Tinkerforge/dc-brick/software/examples/labview/Example Configuration.vi.png

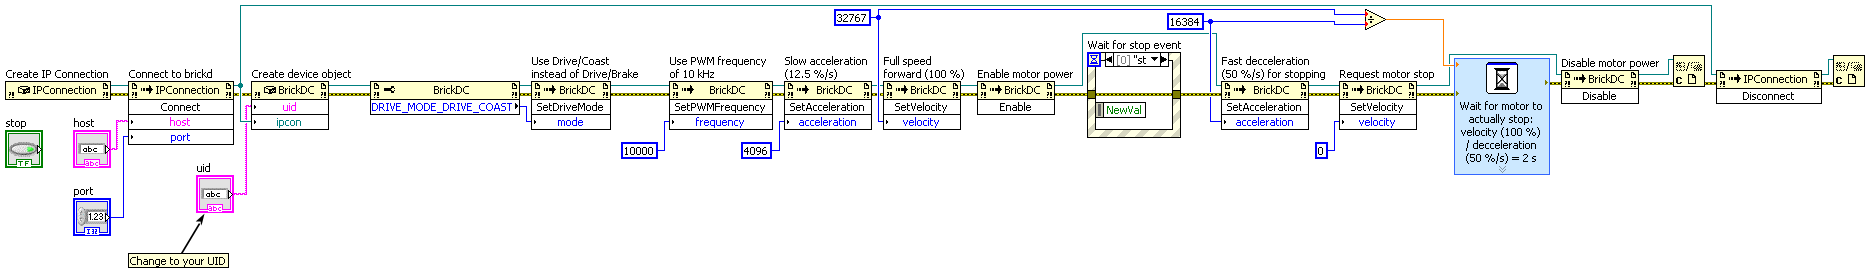
software/examples/labview/Example Configuration.vi.png
