Tinkerforge/dc-brick/hardware/errata.txt

put more space between components and mounting holes
update mounting holes
connectors placement as step down power supply
