Tinkerforge/dc-brick/hardware/dc-schematic.pdf

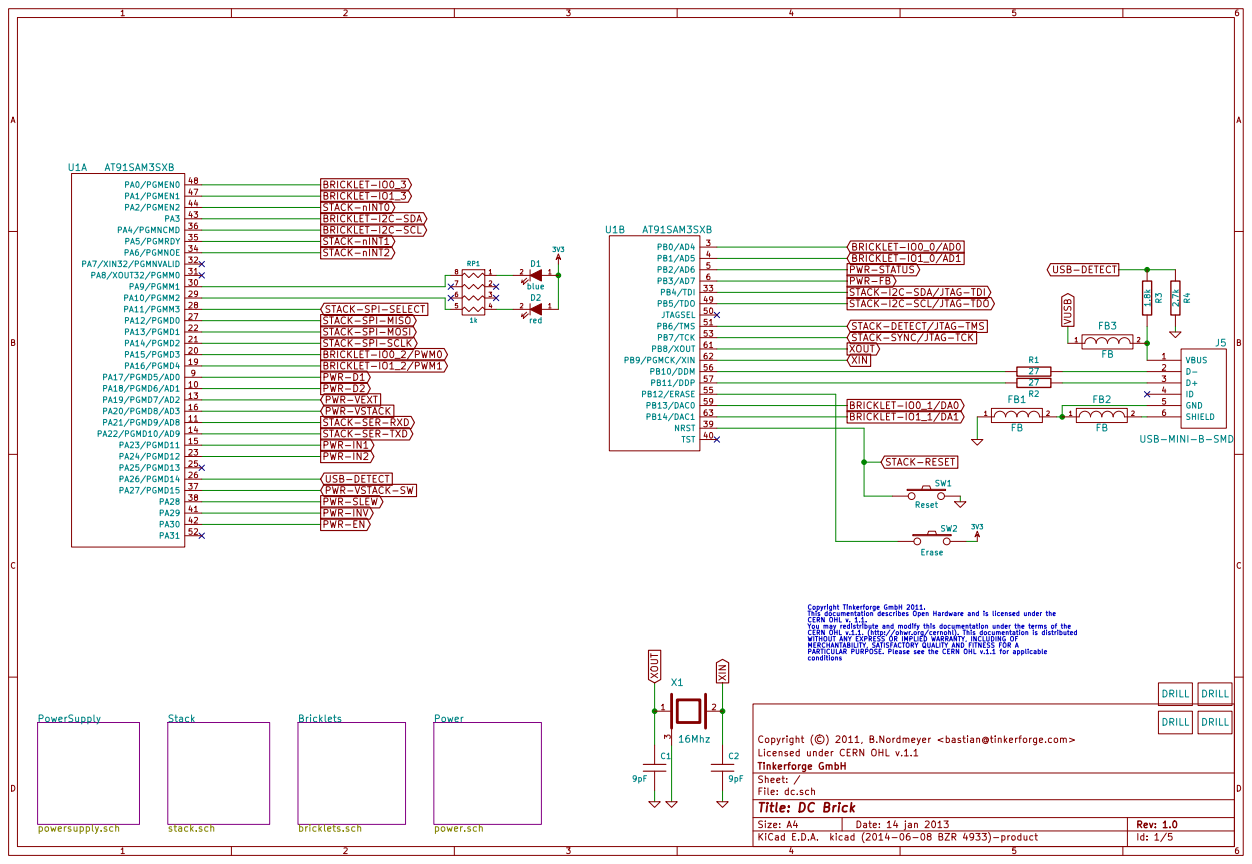
[picture p3: page 1]

BRICKLET-IO0_2/PWM0 Bricklets bricklets.sch
BRICKLET-IO1_2/PWM1
PWR-D2 PWR-D1 PWR-IN2 PWR-IN1 PWR-EN

BRICKLET-IO0_0/AD0
BRICKLET-IO1_0/AD1
PWR-STATUS
PWR-FB
STACK-I2C-SDA/JTAG-TDI
STACK-I2C-SCL/JTAG-TDO

STACK-DETECT/JTAG-TMS
STACK-SYNC/JTAG-TCK
XOUT
XIN

Copyright Tinkerforge GmbH 2011. This documentation describes Open Hardware and is licensed under the CERN OHL v. 1.1. You may redistribute and modify this documentation under the terms of the CERN OHL v.1.1. (http://ohwr.org/cernohl). This documentation is distributed WITHOUT ANY EXPRESS OR IMPLIED WARRANTY, INCLUDING OF MERCHANTABILITY, SATISFACTORY QUALITY AND FITNESS FOR A

PARTICULAR PURPOSE. Please see the CERN OHL v.1.1 for applicable
conditions

Licensed under CERN OHL v.1.1 Copyright (©) 2011, B.Nordmeyer <bastian@tinkerforge.com>

File: dc.sch Sheet: / Tinkerforge GmbH

Id: 1/5 Title: DC Brick

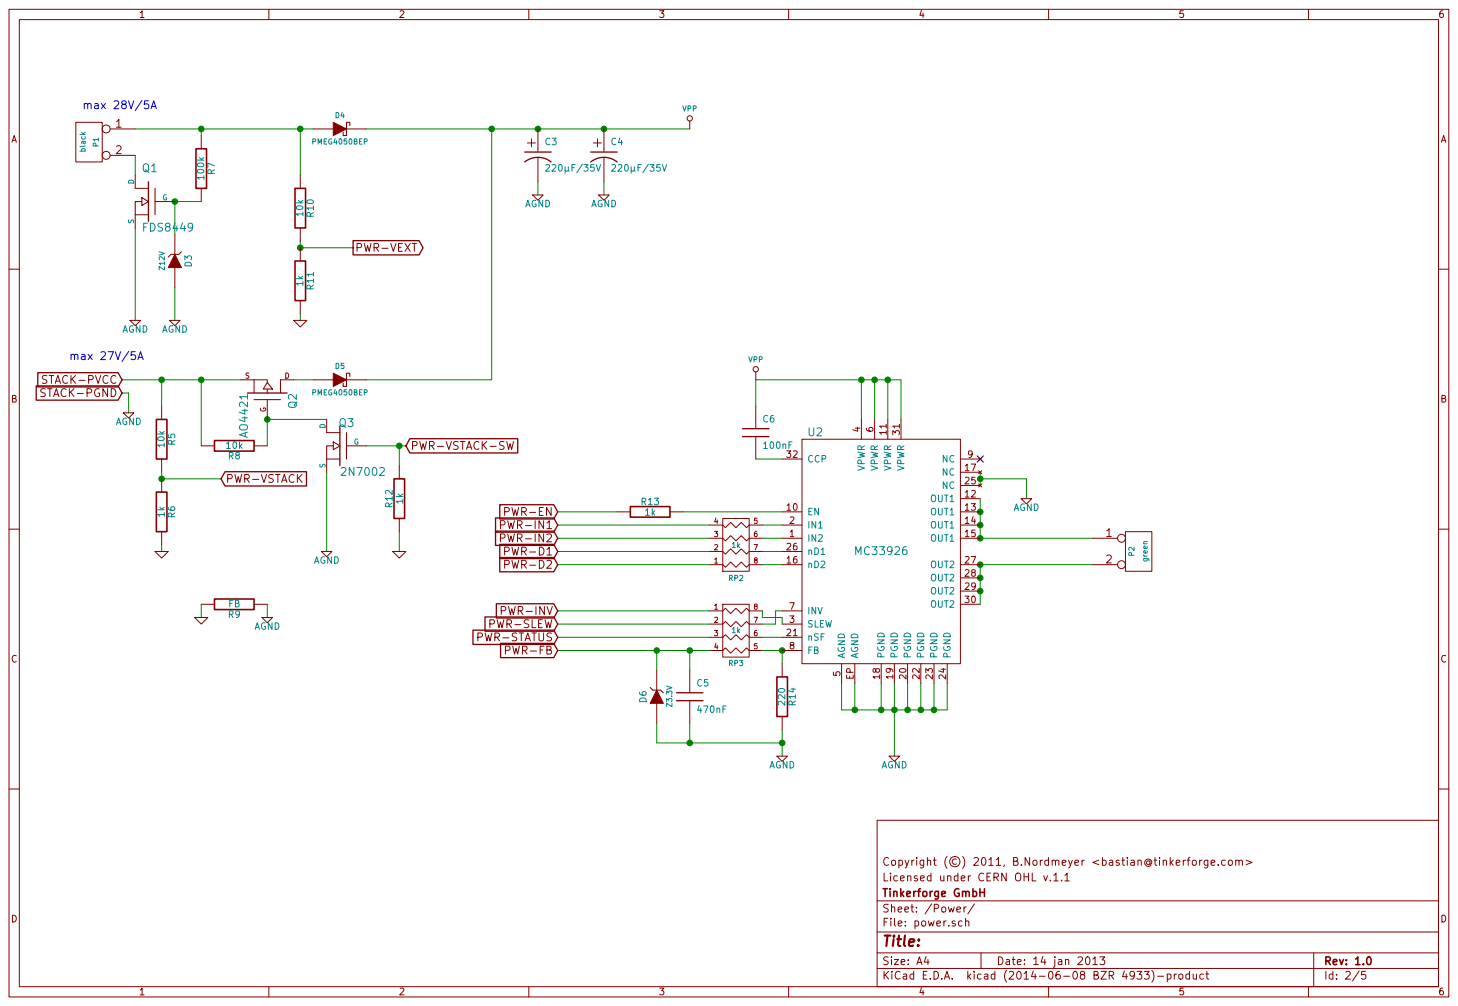
[picture p4: page 2]

Licensed under CERN OHL v.1.1 Copyright (©) 2011, B.Nordmeyer <bastian@tinkerforge.com> PWR-D2

File: power.sch Sheet: /Power/ Tinkerforge GmbH

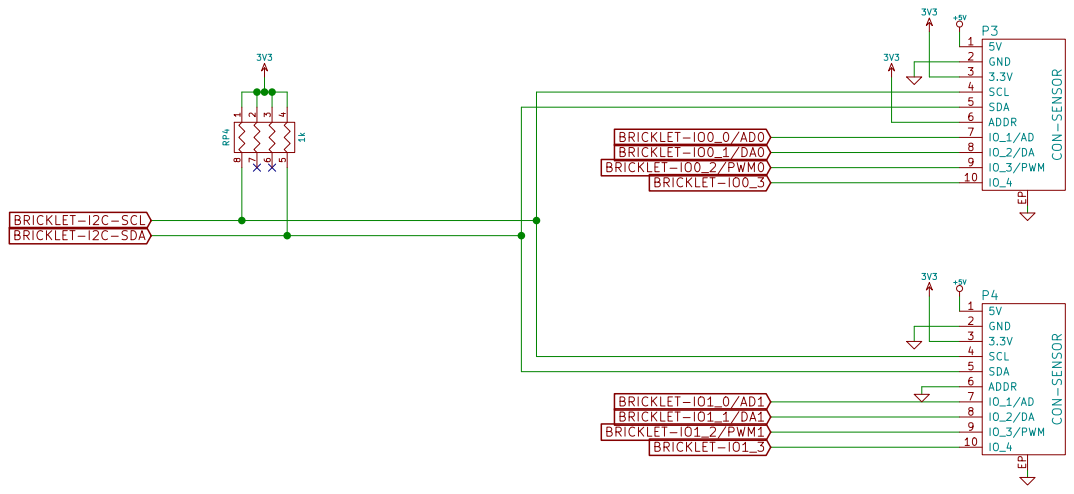
[picture p5: page 3]

Id: 3/5 Title: File: bricklets.sch Sheet: /Bricklets/ Tinkerforge GmbH

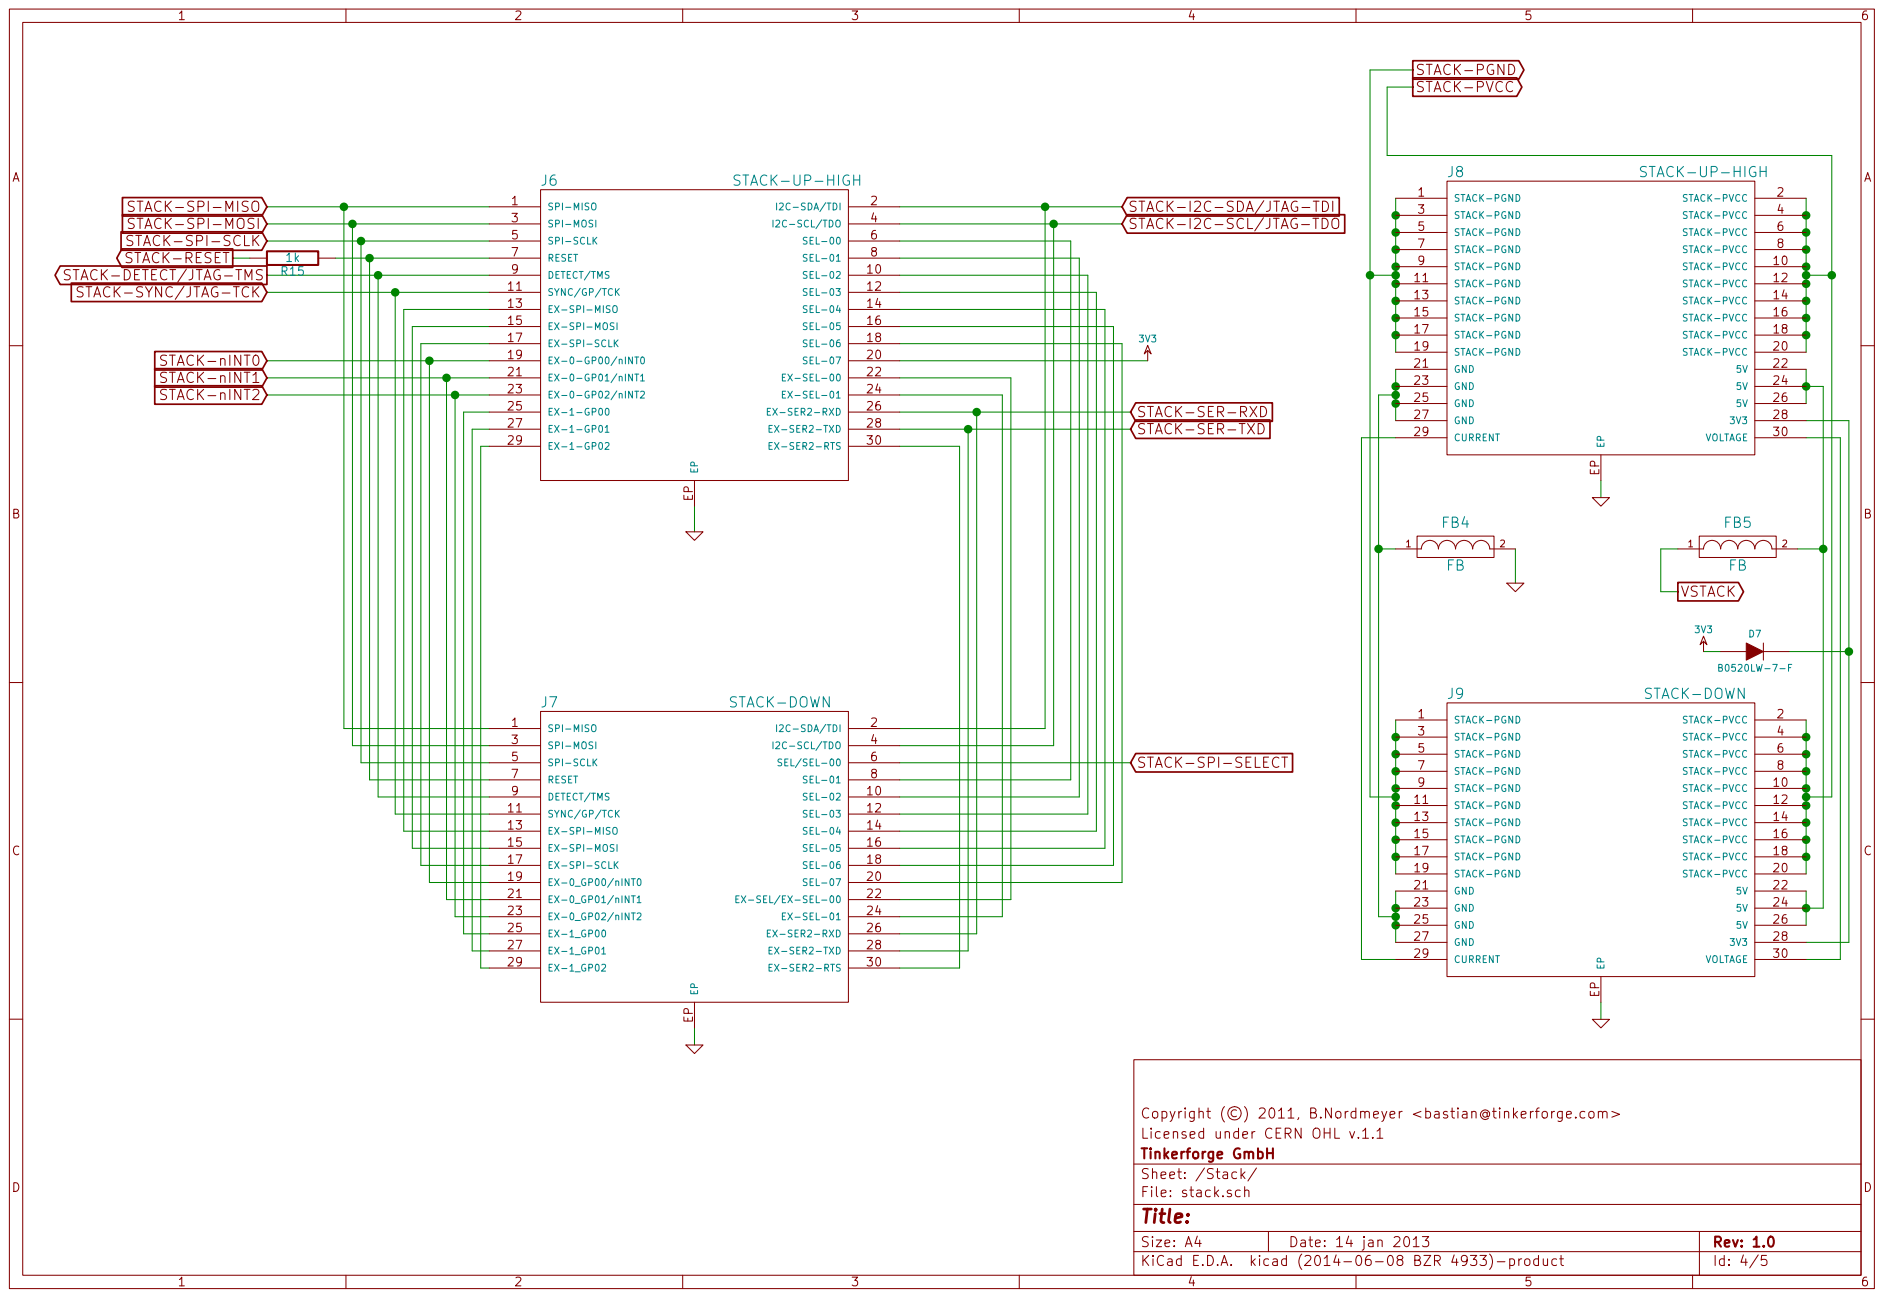
[picture p6: page 4]

STACK-I2C-SDA/JTAG-TDI
STACK-I2C-SCL/JTAG-TDO

STACK-DETECT/JTAG-TMS
STACK-SYNC/JTAG-TCK

Licensed under CERN OHL v.1.1 Copyright (©) 2011, B.Nordmeyer <bastian@tinkerforge.com>

Id: 4/5 Title: File: stack.sch Sheet: /Stack/ Tinkerforge GmbH

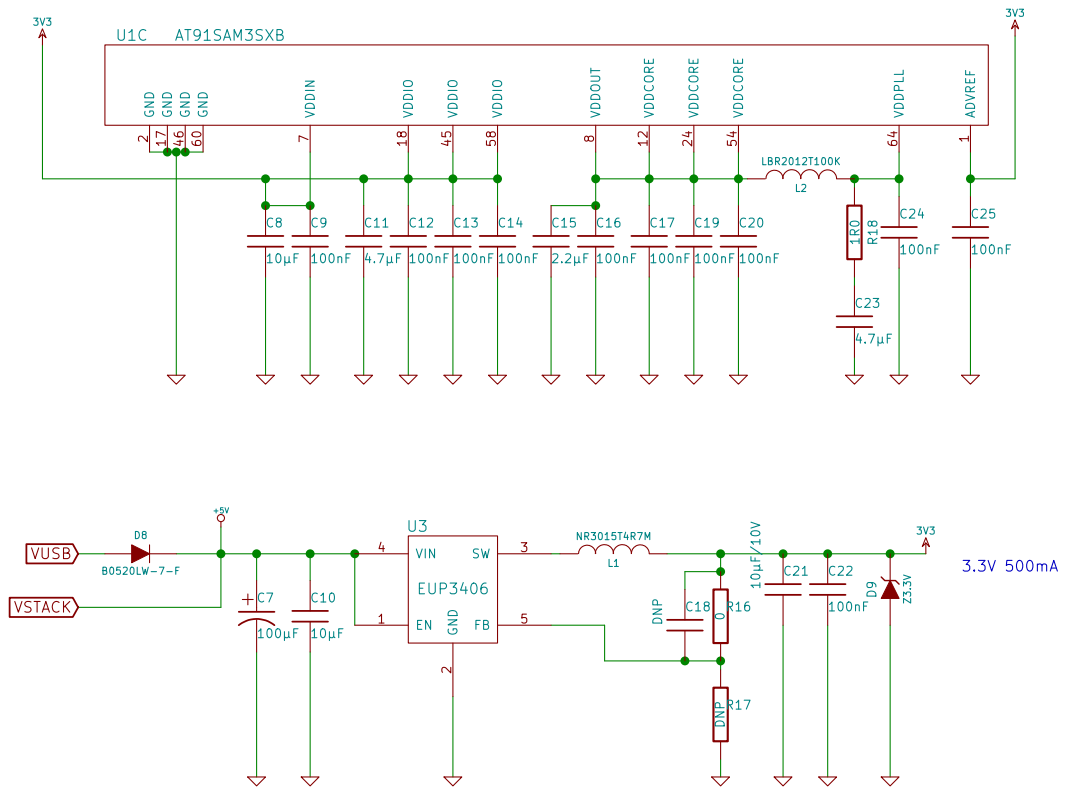
[picture p7: page 5]

8 GND 60 VDDCORE 12 VDDCORE 24 VDDCORE 54 VDDPLL 64 VDDIO 45 GND 46 GND 17 VDDIO 18 VDDIO 58

Licensed under CERN OHL v.1.1 Copyright (©) 2011, B.Nordmeyer <bastian@tinkerforge.com>

D Date: 14 jan 2013
