Tinkerforge/dc-brick/hardware/dc.kicad_pcb

## KiCad design hardware/dc.kicad_pcb (2018-07-20)

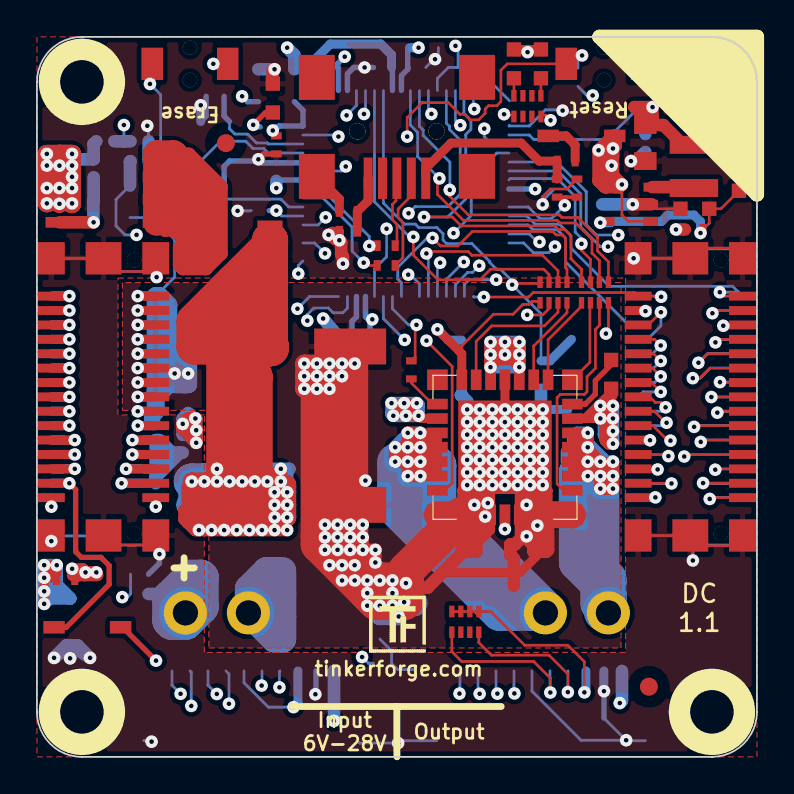
[picture p8: board dc.kicad_pcb from above]

Board: 4 copper layers, 40.0 x 40.0 mm, 92 parts (0 on the bottom side), 102 nets.

Parts:
C1, C2: 9pF; C0402
C3, C4: 220µF/35V; ELKO_83
C5: 470nF; C0603
C6: 100nF; C0603
C7: 100µF; 3528-21
C8, C10: 10µF; C0805
C9, C12, C13, C14, C16, C17, C19, C20, C22, C24, C25: 100nF; C0402
C11, C23: 4.7µF; C0603
C15: 2.2µF; C0603
C18: DNP; C0402
C21: 10µF/10V; C0805
D1: blue; D0603
D2: red; D0603
D3: Z12V; SOD-123
D4, D5: PMEG4050BEP; SOD-128
D6, D9: Z3.3V; SOD-123
D7, D8: B0520LW-7-F; SOD-123
FB1, FB2, FB3, FB4, FB5: FB; C0402
Fiducial_Mark: VAL**; Fiducial_Mark
Fiducial_Mark#2, Fiducial_Mark#3, Fiducial_Mark#4: VAL**; Fiducial_Mark
J1, J2, J3, J4: DRILL; DRILL_NP
J5: USB-MINI-B-SMD
J6, J8: STACK-UP-HIGH; BTB08-ACS-TOP
J7, J9: STACK-DOWN; BTB08-ACS-BTM
L1: NR3015T4R7M; NR3030
L2: LBR2012T100K; C0805
P1: black; OQ_2P
P2: green; OQ_2P
P3, P4: CON-SENSOR
Q1: FDS8449; SOIC-8-MOSFET
Q2: AO4421; SOIC-8-MOSFET
Q3: 2N7002; SOT23GDS
R1, R2: 27; R0402
R3: 1.8k; R0402
R4: 2.7k; R0402
R5, R8, R10: 10k; R0402
R6, R11, R12, R13, R15: 1k; R0402
R7: 100k; R0402
R9: FB; C0603
R14: 220; R1206
R16: 0; R0603
R17: DNP; R0603
R18: 1R0; R0402
RP1, RP2, RP3, RP4: 1k; 4X0402
Ref**: Val**
SW1: Reset; TACT-SWITCH
SW2: Erase; TACT-SWITCH
U1: AT91SAM3SXB; LQFP64
U2: MC33926; PQFN-32
U3: EUP3406; SOT23-5
VAL: CE_5mm
VAL#2: WEEE_7mm
X1: 16Mhz; CRYSTAL_3225

Connections:
3V3: C8.1, C9.1, C11.1, C12.1, C13.1, C14.1, C18.1, C21.1, C22.1, C25.1, D1.1, D2.1, D7.1, D9.2, J6.20, L1.2, P3.3, P3.6, P4.3, R16.1, RP4.1, RP4.2, RP4.3, RP4.4, SW2.2, U1.1, U1.7, U1.18, U1.45, U1.58
BRICKLET-I2C-SCL: P3.4, P4.4, RP4.8, U1.36
BRICKLET-I2C-SDA: P3.5, P4.5, RP4.5, U1.43
BRICKLET-IO0_0/AD0: P3.7, U1.3
BRICKLET-IO0_1/DA0: P3.8, U1.59
BRICKLET-IO0_2/PWM0: P3.9, U1.20
BRICKLET-IO0_3: P3.10, U1.48
BRICKLET-IO1_0/AD1: P4.7, U1.4
BRICKLET-IO1_1/DA1: P4.8, U1.63
BRICKLET-IO1_2/PWM1: P4.9, U1.19
BRICKLET-IO1_3: P4.10, U1.47
GND: C1.2, C2.2, C7.2, C8.2, C9.2, C10.2, C11.2, C12.2, C13.2, C14.2, C15.2, C16.2, C17.2, C19.2, C20.2, C21.2, C22.2, C23.2, C24.2, C25.2, D9.1, FB1.1, FB4.2, J6.EP, J7.EP, J8.EP, J9.EP, P3.2, P3.EP, P4.2, P4.6, P4.EP, R4.1, R6.2, R9.2, R11.2, R12.1, R17.2, SW1.2, U1.2, U1.17, U1.46, U1.60, U3.2, X1.3
unnamed: C6.2, U2.32
unnamed: C15.1, C16.1, C17.1, C19.1, C20.1, L2.1, U1.8, U1.12, U1.24, U1.54
unnamed: C18.2, R16.2, R17.1, U3.5
unnamed: C23.1, R18.1
unnamed: C24.1, L2.2, R18.2, U1.64
unnamed: D1.2, RP1.1
unnamed: D2.2, RP1.4
unnamed: D3.2, Q1.G, R7.2
unnamed: D4.1, P1.1, R7.1, R10.1
unnamed: D5.1, Q2.D
unnamed: D7.2, J8.28, J9.28
unnamed: FB1.2, FB2.1, J5.5
unnamed: FB2.2, J5.6
unnamed: FB3.2, J5.1, R3.1
unnamed: FB4.1, J8.21, J8.23, J8.25, J8.27, J9.21, J9.23, J9.25, J9.27
unnamed: FB5.2, J8.22, J8.24, J8.26, J9.22, J9.24, J9.26
unnamed: J5.2, R1.1
unnamed: J5.3, R2.1
unnamed: J6.6, J7.8
unnamed: J6.7, J7.7, R15.1
unnamed: J6.8, J7.10
unnamed: J6.10, J7.12
unnamed: J6.12, J7.14
unnamed: J6.13, J7.13
unnamed: J6.14, J7.16
unnamed: J6.15, J7.15
unnamed: J6.16, J7.18
unnamed: J6.17, J7.17
unnamed: J6.18, J7.20
unnamed: J6.22, J7.22
unnamed: J6.24, J7.24
unnamed: J6.25, J7.25
unnamed: J6.27, J7.27
unnamed: J6.29, J7.29
unnamed: J6.30, J7.30
unnamed: J8.29, J9.29
unnamed: J8.30, J9.30
unnamed: L1.1, U3.3
unnamed: P1.2, Q1.D
unnamed: P2.1, U2.12, U2.13, U2.14, U2.15
unnamed: P2.2, U2.27, U2.28, U2.29, U2.30
unnamed: Q2.G, Q3.D, R8.1
unnamed: R1.2, U1.56
unnamed: R2.2, U1.57
unnamed: R13.2, U2.10
unnamed: R14.1, RP3.5, U2.8
unnamed: RP1.5, U1.29
unnamed: RP1.8, U1.30
unnamed: RP2.5, U2.2
unnamed: RP2.6, U2.1
unnamed: RP2.7, U2.26
unnamed: RP2.8, U2.16
unnamed: RP3.6, U2.21
unnamed: RP3.7, U2.7
unnamed: RP3.8, U2.3
unnamed: SW2.1, U1.55
PWR-D1: RP2.2, U1.9
PWR-D2: RP2.1, U1.10
PWR-EN: R13.1, U1.42
PWR-FB: C5.1, D6.2, RP3.4, U1.6
PWR-IN1: RP2.4, U1.15
PWR-IN2: RP2.3, U1.23
PWR-INV: RP3.1, U1.41
PWR-SLEW: RP3.2, U1.38
PWR-STATUS: RP3.3, U1.5
PWR-VEXT: R10.2, R11.1, U1.13
PWR-VSTACK: R5.2, R6.1, U1.16
PWR-VSTACK-SW: Q3.G, R12.2, U1.37
STACK-DETECT/JTAG-TMS: J6.9, J7.9, U1.51
STACK-I2C-SCL/JTAG-TDO: J6.4, J7.4, U1.49
STACK-I2C-SDA/JTAG-TDI: J6.2, J7.2, U1.33
STACK-PGND: C3.2, C4.2, C5.2, D3.1, D6.1, J8.1, J8.3, J8.5, J8.7, J8.9, J8.11, J8.13, J8.15, J8.17, J8.19, J9.1, J9.3, J9.5, J9.7, J9.9, J9.11, J9.13, J9.15, J9.17, J9.19, Q1.S, Q3.S, R9.1, R14.2, U2.5, U2.17, U2.18, U2.19, U2.20, U2.22, U2.23, U2.24, U2.25, U2.EP
STACK-PVCC: J8.2, J8.4, J8.6, J8.8, J8.10, J8.12, J8.14, J8.16, J8.18, J8.20, J9.2, J9.4, J9.6, J9.8, J9.10, J9.12, J9.14, J9.16, J9.18, J9.20, Q2.S, R5.1, R8.2
STACK-RESET: R15.2, SW1.1, U1.39
STACK-SER-RXD: J6.26, J7.26, U1.11
STACK-SER-TXD: J6.28, J7.28, U1.14
STACK-SPI-MISO: J6.1, J7.1, U1.27
STACK-SPI-MOSI: J6.3, J7.3, U1.22
STACK-SPI-SCLK: J6.5, J7.5, U1.21
STACK-SPI-SELECT: J7.6, U1.28
STACK-SYNC/JTAG-TCK: J6.11, J7.11, U1.53
STACK-nINT0: J6.19, J7.19, U1.44
STACK-nINT1: J6.21, J7.21, U1.35
STACK-nINT2: J6.23, J7.23, U1.34
USB-DETECT: R3.2, R4.2, U1.26
VPP: C3.1, C4.1, C6.1, D4.2, D5.2, U2.4, U2.6, U2.11, U2.31
VSTACK: C7.1, C10.1, D8.2, FB5.1, P3.1, P4.1, U3.1, U3.4
VUSB: D8.1, FB3.1
XIN: C2.1, U1.62, X1.2
XOUT: C1.1, U1.61, X1.1
