Tinkerforge/dc-brick/software/examples/mathematica/ExampleConfiguration.nb.txt

Needs["NETLink`"]
LoadNETAssembly["Tinkerforge",NotebookDirectory[]<>"../../.."]

host="localhost"
port=4223
uid="XXYYZZ"(*Change XXYYZZ to the UID of your DC Brick*)

(*Create IPConnection and device object*)
ipcon=NETNew["Tinkerforge.IPConnection"]
dc=NETNew["Tinkerforge.BrickDC",uid,ipcon]
ipcon@Connect[host,port]

dc@SetDriveMode[Tinkerforge`BrickDC`DRIVEUMODEUDRIVEUCOAST]
dc@SetPWMFrequency[10000](*Use PWM frequency of 10 kHz*)
dc@SetAcceleration[4096](*Slow acceleration (12.5 %/s)*)
dc@SetVelocity[32767](*Full speed forward (100 %)*)
dc@Enable[](*Enable motor power*)

Input["Click OK to exit"]

(*Stop motor before disabling motor power*)
dc@SetAcceleration[16384](*Fast decceleration (50 %/s) for stopping*)
dc@SetVelocity[0](*Request motor stop*)
Pause[2](*Wait for motor to actually stop: velocity (100 %) / decceleration (50 %/s) = 2 s*)
dc@Disable[](*Disable motor power*)

ipcon@Disconnect[]
ReleaseNETObject[dc]
ReleaseNETObject[ipcon]
