Tinkerforge/dc-brick/(commit log)

2011-08-25 initial hardware source commit
    [bricklets.sch, dc.brd, dc.sch, power.sch, powersupply.sch, stack.sch]
2011-08-25 change voltage epsilon from 200mV to 1000mV
2011-08-26 do configuration of power management only once
2011-08-26 remove adc tc and fix wrong pin for bricklet port
    [config.h]
2011-08-26 fix wrong pullup for powerswitching (1k -> 10k) add missing licence comment in brd file
    [bricklets.sch, dc.brd, dc.sch, power.sch, powersupply.sch, stack.sch]
2011-08-26 change diode PMEG1020EH -> B0520LW-7-F
    [dc.brd, powersupply.sch, stack.sch]
2011-08-26 schematic adapted, since diode was changed
2011-09-06 add red led error status code
    [dc.c, dc.h]
2011-09-08 use voltage epsilon to switch between external and stack voltage
2011-09-13 add java bindings and examples
    [ExampleCallback.java, ExampleConfiguration.java]
2011-09-15 fix copy and paste fail in java example comments
    [ExampleCallback.java]
2011-10-05 Remove Bindings and IP Connection (these are generated and they change too often) and rename bindings to examples
    [ExampleCallback.java, ExampleConfiguration.java, example_callback.c, example_configuration.c]
2012-02-13 checkin of Version V1.0 no major things changed - fiducials on board
    [bricklets.sch, dc.brd, dc.sch, power.sch, powersupply.sch, stack.sch]
2012-02-13 fix broken version numbers in schematics
    [bricklets.sch, dc.sch, power.sch, powersupply.sch, stack.sch]
2012-03-05 Fix bug with timeouts on windows (through bricklib)
    [config.h]
2012-03-11 Fix bug with ADC calibration readout (through bricklib)
    [config.h]
2012-06-29 Add get_temperature and reset function (through bricklib)
    [config.h, main.c]
2012-07-02 Fix USB product description
    [config.h]
2012-07-11 Add averaging for current measurement
2012-07-25 Fix typos in C/C++ examples
    [example_callback.c, example_configuration.c]
2012-09-19 Fix typo in examples
    [ExampleConfiguration.java, example_configuration.c]
2012-09-20 Set Interrupt pins to default (otherwise they can interfere with WIFI)
    [config.h, main.c]
2012-12-11 Avoid g++ warnings about missing casts in C examples
    [example_callback.c]
2013-01-09 Use specific device object for callbacks
2013-04-11 Add watchdog and currently unused support for encoder
2013-06-27 Use tick_task to detect usb connect/disconnect instead of interrupt (through bricklib)
2014-02-07 Add Mathematica examples
    [ExampleConfiguration.nb.txt]
2014-04-02 perl: Unify print style
2014-06-12 change voltage divider for usb detect add errata file
    [bricklets.sch, dc.brd, dc.sch, power.sch, powersupply.sch, stack.sch]
2014-07-15 java: Replace System.console() usage with an Eclipse compatible pattern
    [ExampleCallback.java, ExampleConfiguration.java]
2014-11-25 Use new SPI protocol
2015-01-19 python: Stop motor before ending program
    This should be done in all other examples as well.
2015-01-19 examples: Stop motor before ending program
    [ExampleConfiguration.nb.txt]
2015-08-07 Use full device class name in Python examples
2015-08-12 Fix minor warnings in C/C++ examples
    [example_callback.c, example_configuration.c]
2015-09-30 Generator based example cleanup
    [ExampleConfiguration.nb.txt]
2016-04-04 Always set PWM when changing dc_velocity
    Otherwise the PWM setting and the dc_velocity can get out-of-sync.
    For example, enable motor, set dc_velocity_goal > 0 (tick sets
    dc_velocity > 0), disable motor (dc_velocity = 0, but PWM stays > 0),
    set dc_velocity_goal = 0, enable motor. Now the tick sees that
    dc_velocity_goal == dc_velocity == 0 and doesn't change PWM. PWM
    stays > 0 even if it should be 0.
    This problem is triggerd by setting dc_velocity = 0 in dc_disable
    without also setting PWM = 0.
    [config.h, dc.c]
2016-05-18 c: Add missing device destroy call
    [example_callback.c, example_configuration.c]
2016-07-01 Make the change UID comment more explicit
    [ExampleConfiguration.nb.txt]
2016-12-05 Add ringbuffer and system timer utility as well as co_mcu support files to Makefile (all added through bricklib)
2016-12-28 add hint for connector placement
2017-06-23 *.brd to *.kicad_pcb
    [dc.brd, dc.kicad_pcb]
2017-06-23 Add 3d information (tbc), change direction of diodes
    [bricklets.sch, dc.sch, power.sch, powersupply.sch, stack.sch]
2017-06-30 Add 3d information (tbc); fix direction of some diodes
    [bricklets.sch, dc.kicad_pcb, dc.sch, power.sch, powersupply.sch, stack.sch]
2017-07-07 Add 3d information (final)
    [dc.kicad_pcb]
2017-08-01 Add 3d component: NR3030
    [dc.kicad_pcb]
2017-11-28 fix partial routing due to footprint size increases
    [dc.kicad_pcb]
2017-11-28 dc brick version 1.1
    * fix motor connector position
    [dc.kicad_pcb]
2017-11-28 fix ce and weee logo
    [dc.kicad_pcb]
2018-01-11 Increase version number (message duplication bug fix through bricklib)
    [config.h]
2018-02-20 Cleanup KiCad libraries config
    Ensure LibDir=kicad-libraries and LibName1=tinkerforge.
    Remove special library.
2018-05-28 mathematica: Fix namespace
    [ExampleConfiguration.nb.txt]
2018-07-20 Add new 3d model
    [dc.kicad_pcb]
2018-11-07 rust: Accept host names for ip connection, fix naming inconsistencies
    [example_callback.rs, example_configuration.rs]
2019-01-24 mqtt: Add examples.
    [example-configuration.txt]
2019-01-24 mqtt: Fix example header.
    [example-configuration.txt]
2019-01-24 mqtt: Remove executable bit in example permissions.
    [example-configuration.txt]
2019-01-24 mqtt: Minor example fixes.
    [example-configuration.txt]
2019-08-22 c: Adapt to bindings changes
    [example_callback.c]
2020-01-13 examples: mqtt: Remove trailing whitespace.
    [example-configuration.txt]
2020-03-19 examples: Properly stop motor before disabling motor power
    Disabling motor power while motor is still running could cause
    hardware damage.
    [ExampleConfiguration.nb.txt, example-configuration.txt]
2020-04-07 examples: Add missing imports for sleep calls
    [example_callback.rs, example_configuration.rs]
2020-04-07 examples: rust: Always block when calling bindings functions.
    [example_configuration.rs]
2020-05-14 Fix response length of get_drive_mode.
    [communication.h, config.h]
2020-10-06 fixed symbols and schematic
    [bricklets.sch, dc.sch, power.sch, powersupply.sch, stack.sch]
2021-10-25 Update KiCad link
    https://www.kicad.org/blog/2021/10/Avoid-links-to-former-kicad-domain/
