Tinkerforge/dc-brick/(notices)

Notices in the files:
hardware/dc.kicad_pcb:
Copyright (©) 2017, B.Nordmeyer
Copyright Tinkerforge GmbH 2017.
